Curiosity2611/snap_card/snap_card_schematic_1.3.3.pdf

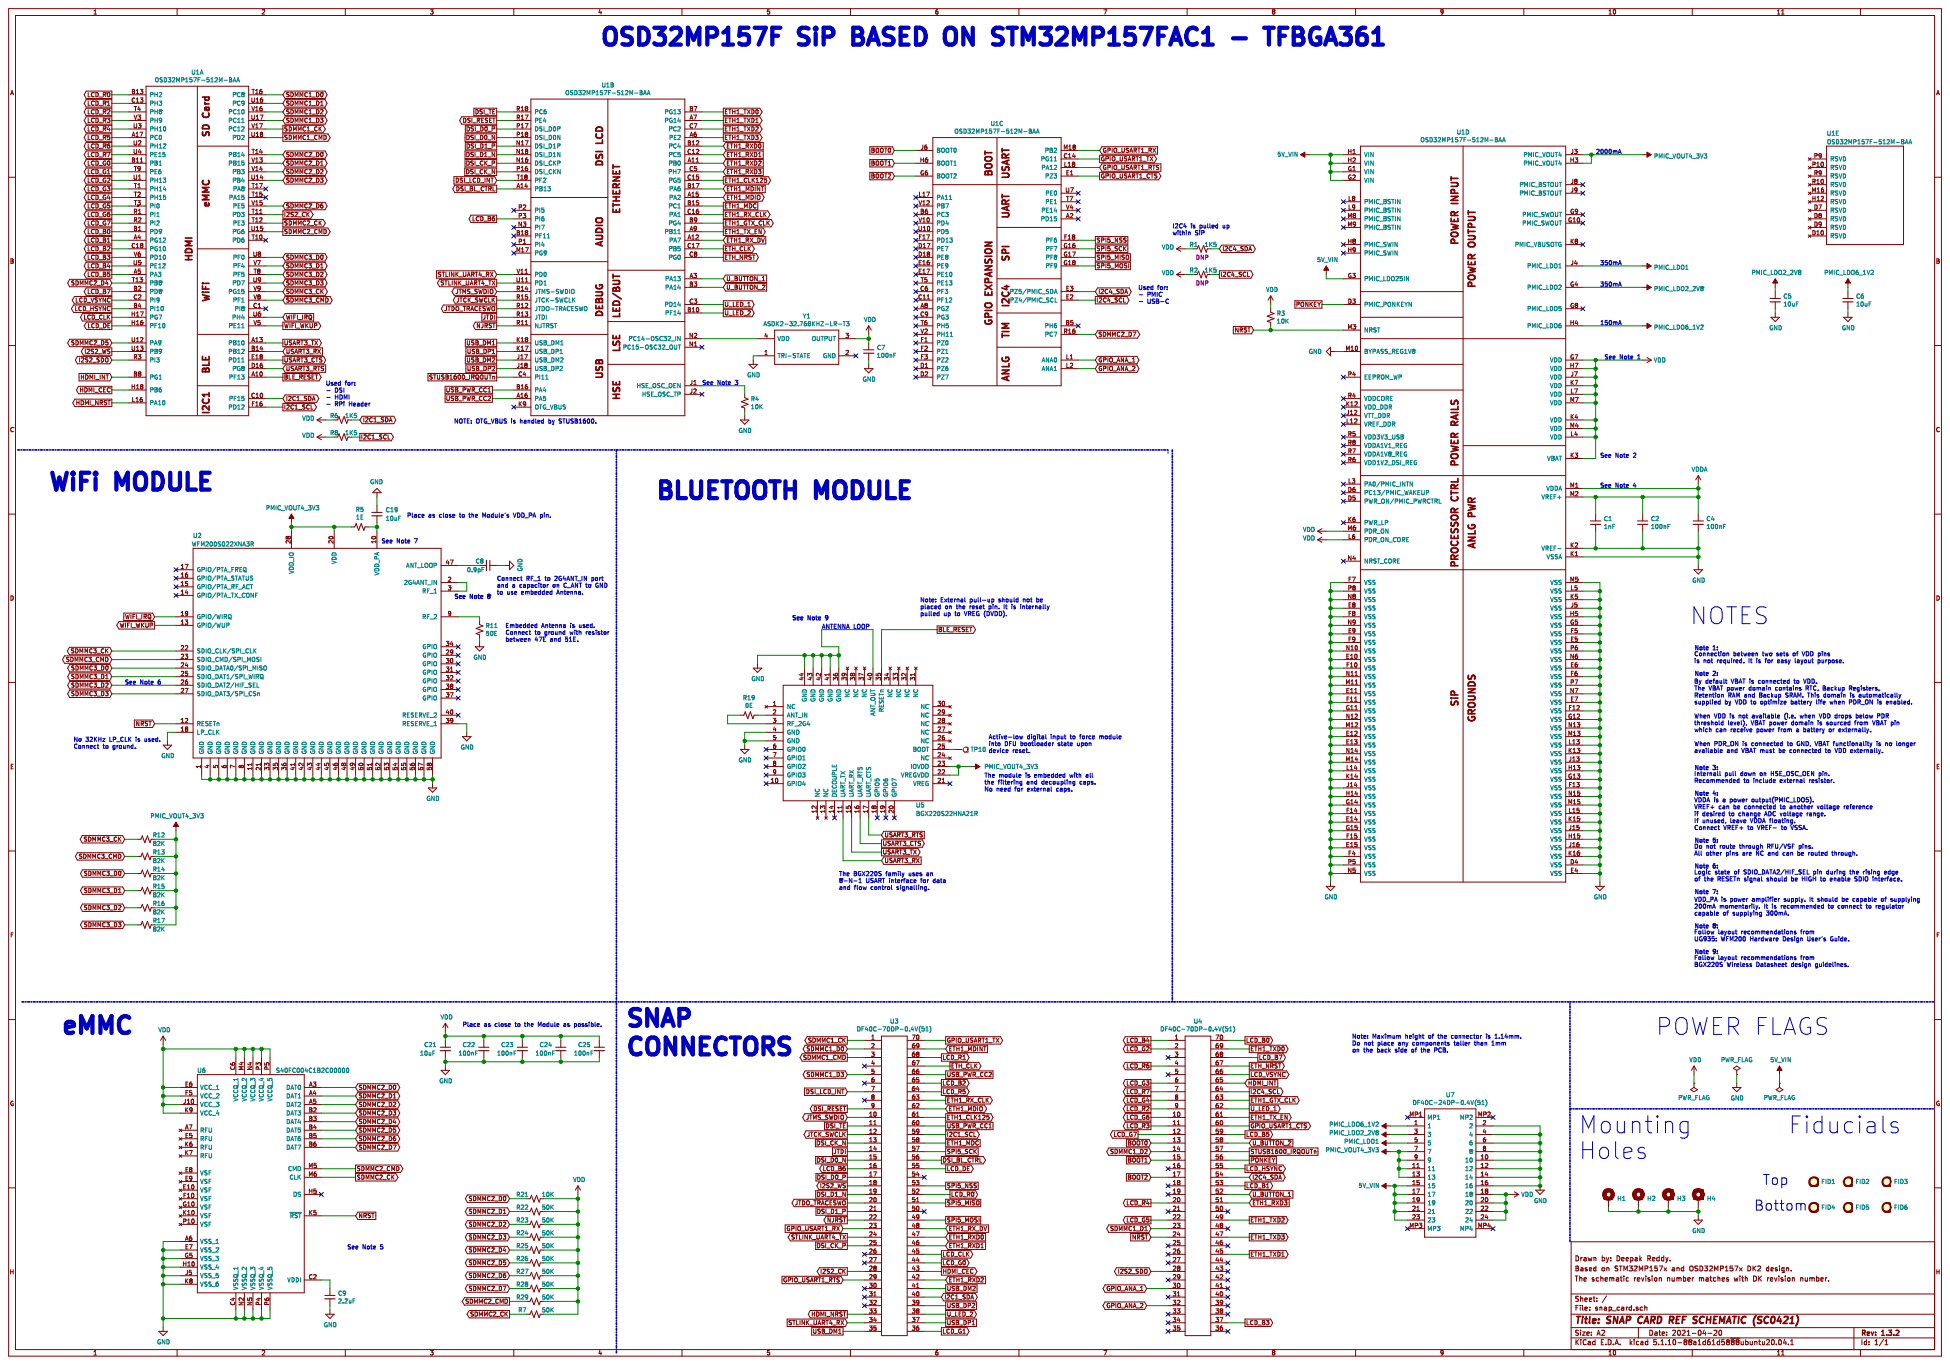
[picture p1: page 1]
