Curiosity2611/snap_card/snap_card.kicad_pcb

## KiCad design snap_card.kicad_pcb (2021-05-15)

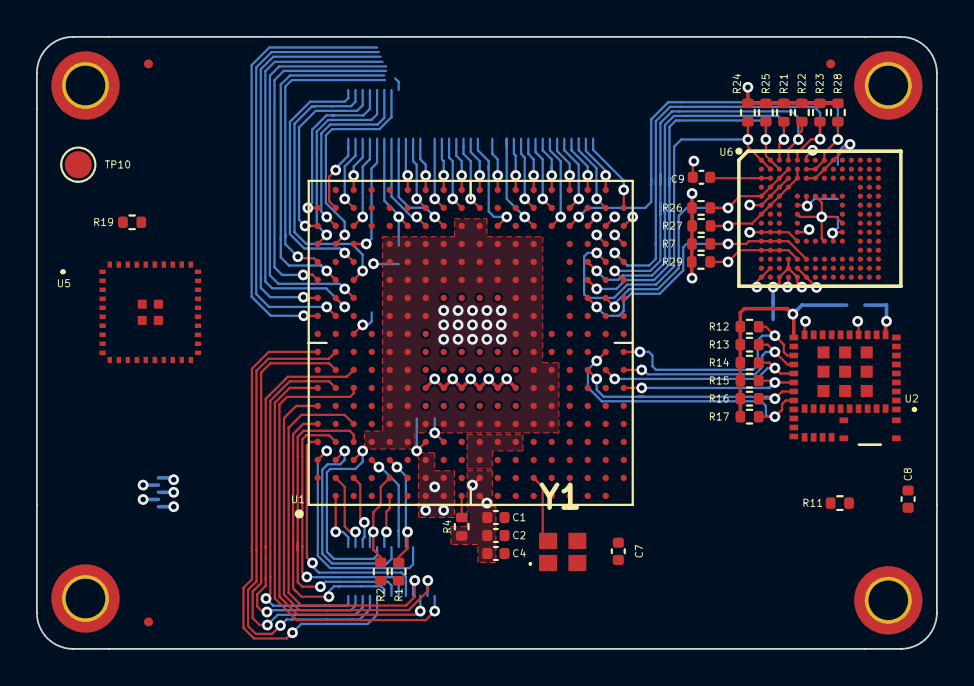
[picture p2: board snap_card.kicad_pcb from above]

Board: 4 copper layers, 50.0 x 34.0 mm, 58 parts (0 on the bottom side), 146 nets.

Parts:
C1: 1nF; C_0402_1005Metric
C2, C4, C7, C22, C23, C24, C25: 100nF; C_0402_1005Metric
C5, C6, C19, C21: 10uF; C_0402_1005Metric
C8: 0.9pF; C_0402_1005Metric
C9: 2.2uF; C_0402_1005Metric
FID1, FID2, FID3, FID4, FID5, FID6: Fiducial; Fiducial_0.5mm_Mask1mm
H1, H2, H3, H4: MountingHole_Pad; MountingHole_2.2mm_M2_DIN965_Pad_TopBottom
R1, R2, R6, R8: 1K5; R_0402_1005Metric
R3, R4, R21: 10K; R_0402_1005Metric
R5: 1E; R_0402_1005Metric
R7, R22, R23, R24, R25, R26, R27, R28, R29: 50K; R_0402_1005Metric
R11: 50E; R_0402_1005Metric
R12, R13, R14, R15, R16, R17: 82K; R_0402_1005Metric
R19: 0E; R_0402_1005Metric
TP10: TestPoint; TestPoint_Pad_D1.5mm
U1: OSD32MP157F-512M-BAA; OSD32MP15X-BGA-324
U2: WFM200S022XNA3R; WFM200S022XNA3
U3, U4: DF40C-70DP-0.4V(51); DF40C70DP04V51
U5: BGX220S22HNA21R; BGX220S22HNA21
U6: S40FC004C1B2C00000
U7: DF40C-24DP-0.4V(51); DF40C24DP04V51
Y1: ASDK2-32.768KHZ-LR-T3; ASDK232768KHZLRT3

Connections:
5V_VIN: U1.G1, U1.G2, U1.G3, U1.H1, U1.H2, U7.15, U7.17, U7.19, U7.21, U7.23
BLE_RESET: U1.A10, U5.35
BOOT0: U1.J6, U4.13
BOOT1: U1.H6, U4.15
BOOT2: U1.G6, U4.17
DSI_BL_CTRL: U1.A14, U3.56
DSI_CK_N: U1.P16, U3.13
DSI_CK_P: U1.N16, U3.25
DSI_D0_N: U1.P18, U3.15
DSI_D0_P: U1.P17, U3.17
DSI_D1_N: U1.N18, U3.19
DSI_D1_P: U1.N17, U3.21
DSI_LCD_INT: U1.T18, U3.7
DSI_RESET: U1.R17, U3.9
DSI_TE: U1.R18, U3.11
ETH1_CLK125: U1.C15, U3.61
ETH1_GTX_CLK: U1.B9, U4.63
ETH1_MDC: U1.B15, U3.58
ETH1_MDINT: U1.B17, U3.69
ETH1_MDIO: U1.A15, U3.62
ETH1_RXD0: U1.B12, U3.47
ETH1_RXD1: U1.C12, U3.46
ETH1_RXD2: U1.A11, U3.42
ETH1_RXD3: U1.C5, U4.51
ETH1_RX_CLK: U1.C16, U3.63
ETH1_RX_DV: U1.A12, U3.48
ETH1_TXD0: U1.B7, U4.69
ETH1_TXD1: U1.A7, U4.45
ETH1_TXD2: U1.C7, U4.49
ETH1_TXD3: U1.A6, U4.47
ETH1_TX_EN: U1.A9, U4.61
ETH_CLK: U1.C17, U3.67
ETH_NRST: U1.C8, U4.67
GND: C1.2, C2.2, C4.2, C5.2, C6.2, C7.2, C8.1, C9.2, C19.1, C21.2, C22.2, C23.2, C24.2, C25.2, H1.1, H2.1, H3.1, H4.1, R4.2, R11.2, U1.D4, U1.E4, U1.E5, U1.E6, U1.E7, U1.E8, U1.E9, U1.E10, U1.E11, U1.E12, U1.E13, U1.E14, U1.E15, U1.F4, U1.F5, U1.F6, U1.F7, U1.F8, U1.F9, U1.F10, U1.F11, U1.F12, U1.F13, U1.F14, U1.F15, U1.G5, U1.G11, U1.G12, U1.G13, U1.G14, U1.G15, U1.H5, U1.H13, U1.H14, U1.H15, U1.J5, U1.J13, U1.J14, U1.J15, U1.J16, U1.K1, U1.K2, U1.K5, U1.K13, U1.K14, U1.K15, U1.K16, U1.L5, U1.L13, U1.L14, U1.L15, U1.M5, U1.M10, U1.M11, U1.M12, U1.M13, U1.M14, U1.M15, U1.N5, U1.N6, U1.N7, U1.N8, U1.N9, U1.N10, U1.N11, U1.N12, U1.N13, U1.N14, U1.N15, U1.P5, U1.P6, U1.P7, U1.P8, U2.1, U2.4, U2.5, U2.6, U2.7, U2.8, U2.11, U2.18, U2.21, U2.33, U2.35, U2.36, U2.39, U2.41, U2.42, U2.43, U2.44, U2.45, U2.46, U2.48, U2.49, U2.50, U2.51, U2.52, U2.53, U2.54, U2.55, U2.56, U2.57, U2.58, U5.4, U5.5, U5.36, U5.40, U5.41, U5.42, U5.43, U5.44, U6.A6, U6.C4, U6.D3, U6.E2, U6.E7, U6.F1, U6.G5, U6.H10, U6.J5, U6.K8, U6.N2, U6.N5, U6.P1, U6.P4, U6.P6, U7.2, U7.4, U7.6, U7.8, U7.10, U7.12, U7.14, U7.16, Y1.1
GPIO_ANA_1: U1.L1, U4.30
GPIO_ANA_2: U1.L2, U4.32
GPIO_USART1_CTS: U1.E1, U4.60
GPIO_USART1_RTS: U1.L18, U3.29
GPIO_USART1_RX: U1.M18, U3.23
GPIO_USART1_TX: U1.C14, U3.70
HDMI_CEC: U1.H18, U3.43
HDMI_INT: U1.B8, U4.65
HDMI_NRST: U1.L16, U3.33
I2C1_SCL: R8.1, U1.F16, U3.59
I2C1_SDA: R6.1, U1.C10, U3.40
I2C4_SCL: R2.1, U1.E2, U4.64
I2C4_SDA: R1.1, U1.E3, U4.54
I2S2_CK: U1.T11, U3.28
I2S2_SDO: U1.R3, U4.28
I2S2_WS: U1.U13, U3.18
JTCK_SWCLK: U1.R15, U3.12
JTDI: U1.R13, U3.14
JTDO_TRACESWO: U1.R12, U3.20
JTMS_SWDIO: U1.R14, U3.10
LCD_B0: U1.B1, U4.70
LCD_B1: U1.A4, U4.53
LCD_B2: U1.C18, U3.65
LCD_B3: U1.V6, U4.37
LCD_B4: U1.U5, U4.1
LCD_B5: U1.A5, U4.59
LCD_B6: U1.P3, U3.16
LCD_B7: U1.B2, U4.68
LCD_CLK: U1.H17, U3.45
LCD_DE: U1.H16, U3.55
LCD_G0: U1.B11, U3.44
LCD_G1: U1.T9, U3.36
LCD_G2: U1.U1, U4.2
LCD_G3: U1.T1, U4.6
LCD_G4: U1.T2, U4.8
LCD_G5: U1.T3, U4.22
LCD_G6: U1.R1, U4.10
LCD_G7: U1.R2, U4.12
LCD_HSYNC: U1.B4, U4.55
LCD_R0: U1.B13, U3.52
LCD_R1: U1.C13, U3.68
LCD_R2: U1.T4, U4.9
LCD_R3: U1.V3, U4.11
LCD_R4: U1.U3, U4.20
LCD_R5: U1.A17, U3.64
LCD_R6: U1.U2, U4.4
LCD_R7: U1.U4, U4.7
LCD_VSYNC: U1.C2, U4.66
NJRST: U1.R11, U3.22
NRST: R3.2, U1.M3, U2.12, U4.24, U6.J1, U6.J2, U6.J3, U6.K5
unnamed: C8.2, U2.47
unnamed: C9.1, U6.C1, U6.C2
unnamed: C19.2, R5.1, U2.10
unnamed: R4.1, U1.J1
unnamed: R11.1, U2.9
unnamed: R19.1, U5.2
unnamed: R19.2, U5.3
unnamed: TP10.1, U5.25
unnamed: U1.N2, Y1.4
unnamed: U2.2, U2.3
PMIC_LDO1: U1.J4, U7.5
PMIC_LDO2_2V8: C5.1, U1.G4, U7.3
PMIC_LDO6_1V2: C6.1, U1.H4, U7.1
PMIC_VOUT4_3V3: R5.2, R12.1, R13.1, R14.1, R15.1, R16.1, R17.1, U1.H3, U1.J3, U2.20, U2.28, U5.22, U5.23, U7.7, U7.9, U7.11, U7.13
PONKEY: U1.D3, U4.56
SDMMC1_CK: U1.V17, U3.1
SDMMC1_CMD: U1.U18, U3.3
SDMMC1_D0: U1.T16, U3.2
SDMMC1_D1: U1.U16, U4.23
SDMMC1_D2: U1.V16, U4.14
SDMMC1_D3: U1.U17, U3.5
SDMMC2_CK: R7.2, U1.T12, U6.K1, U6.K2, U6.K3, U6.M6
SDMMC2_CMD: R29.2, U1.U15, U6.L1, U6.L2, U6.L3, U6.M5
SDMMC2_D0: R21.2, U1.T14, U6.A3
SDMMC2_D1: R22.2, U1.V13, U6.A4
SDMMC2_D2: R23.2, U1.V14, U6.A5
SDMMC2_D3: R24.2, U1.U14, U6.A1, U6.B2
SDMMC2_D4: R25.2, U1.T13, U6.A2, U6.B3
SDMMC2_D5: R26.2, U1.U12, U6.B4, U6.C3, U6.D2, U6.E1
SDMMC2_D6: R27.2, U1.V15, U6.B5, U6.C5, U6.D4, U6.E3, U6.F2, U6.G1
SDMMC2_D7: R28.2, U1.R16, U6.A8, U6.B6, U6.B7
SDMMC3_CK: R12.2, U1.V9, U2.22
SDMMC3_CMD: R13.2, U1.V8, U2.23
SDMMC3_D0: R14.2, U1.U8, U2.24
SDMMC3_D1: R15.2, U1.V7, U2.25
SDMMC3_D2: R16.2, U1.T8, U2.26
SDMMC3_D3: R17.2, U1.U9, U2.27
SPI5_MISO: U1.G17, U3.51
SPI5_MOSI: U1.G18, U3.49
SPI5_NSS: U1.F18, U3.53
SPI5_SCK: U1.G16, U3.57
STLINK_UART4_RX: U1.V11, U3.34
STLINK_UART4_TX: U1.U11, U3.24
STUSB1600_IRQOUTn: U1.C4, U4.57
USART3_CTS: U1.E18, U5.16
USART3_RTS: U1.D16, U5.17
USART3_RX: U1.B14, U5.11
USART3_TX: U1.A13, U5.15
USB_DM1: U1.K18, U3.35
USB_DM2: U1.J17, U3.41
USB_DP1: U1.K17, U3.37
USB_DP2: U1.J18, U3.39
USB_PWR_CC1: U1.B16, U3.60
USB_PWR_CC2: U1.A16, U3.66
U_BUTTON_1: U1.A3, U4.52
U_BUTTON_2: U1.B3, U4.58
U_LED_1: U1.C3, U4.62
U_LED_2: U1.B10, U3.38
VDD: C7.1, C21.1, C22.1, C23.1, C24.1, C25.1, R1.2, R2.2, R3.1, R6.2, R7.1, R8.2, R21.1, R22.1, R23.1, R24.1, R25.1, R26.1, R27.1, R28.1, R29.1, U1.G7, U1.H7, U1.J7, U1.K3, U1.K4, U1.K7, U1.L4, U1.L6, U1.L7, U1.M4, U1.M6, U1.M7, U6.A9, U6.B8, U6.C6, U6.C7, U6.E6, U6.F5, U6.J10, U6.K9, U6.M4, U6.N4, U6.P3, U6.P5, U7.18, U7.20, U7.22, U7.24, Y1.3
VDDA: C1.1, C2.1, C4.1, U1.M1, U1.M2
WIFI_IRQ: U1.U6, U2.19
WIFI_WKUP: U1.V5, U2.13
